ShawkyHanna/ovc/ovc5/hardware/carrier/interfaces.kicad_sch

## KiCad design ovc5/hardware/carrier/interfaces.kicad_sch (2021-05-21)

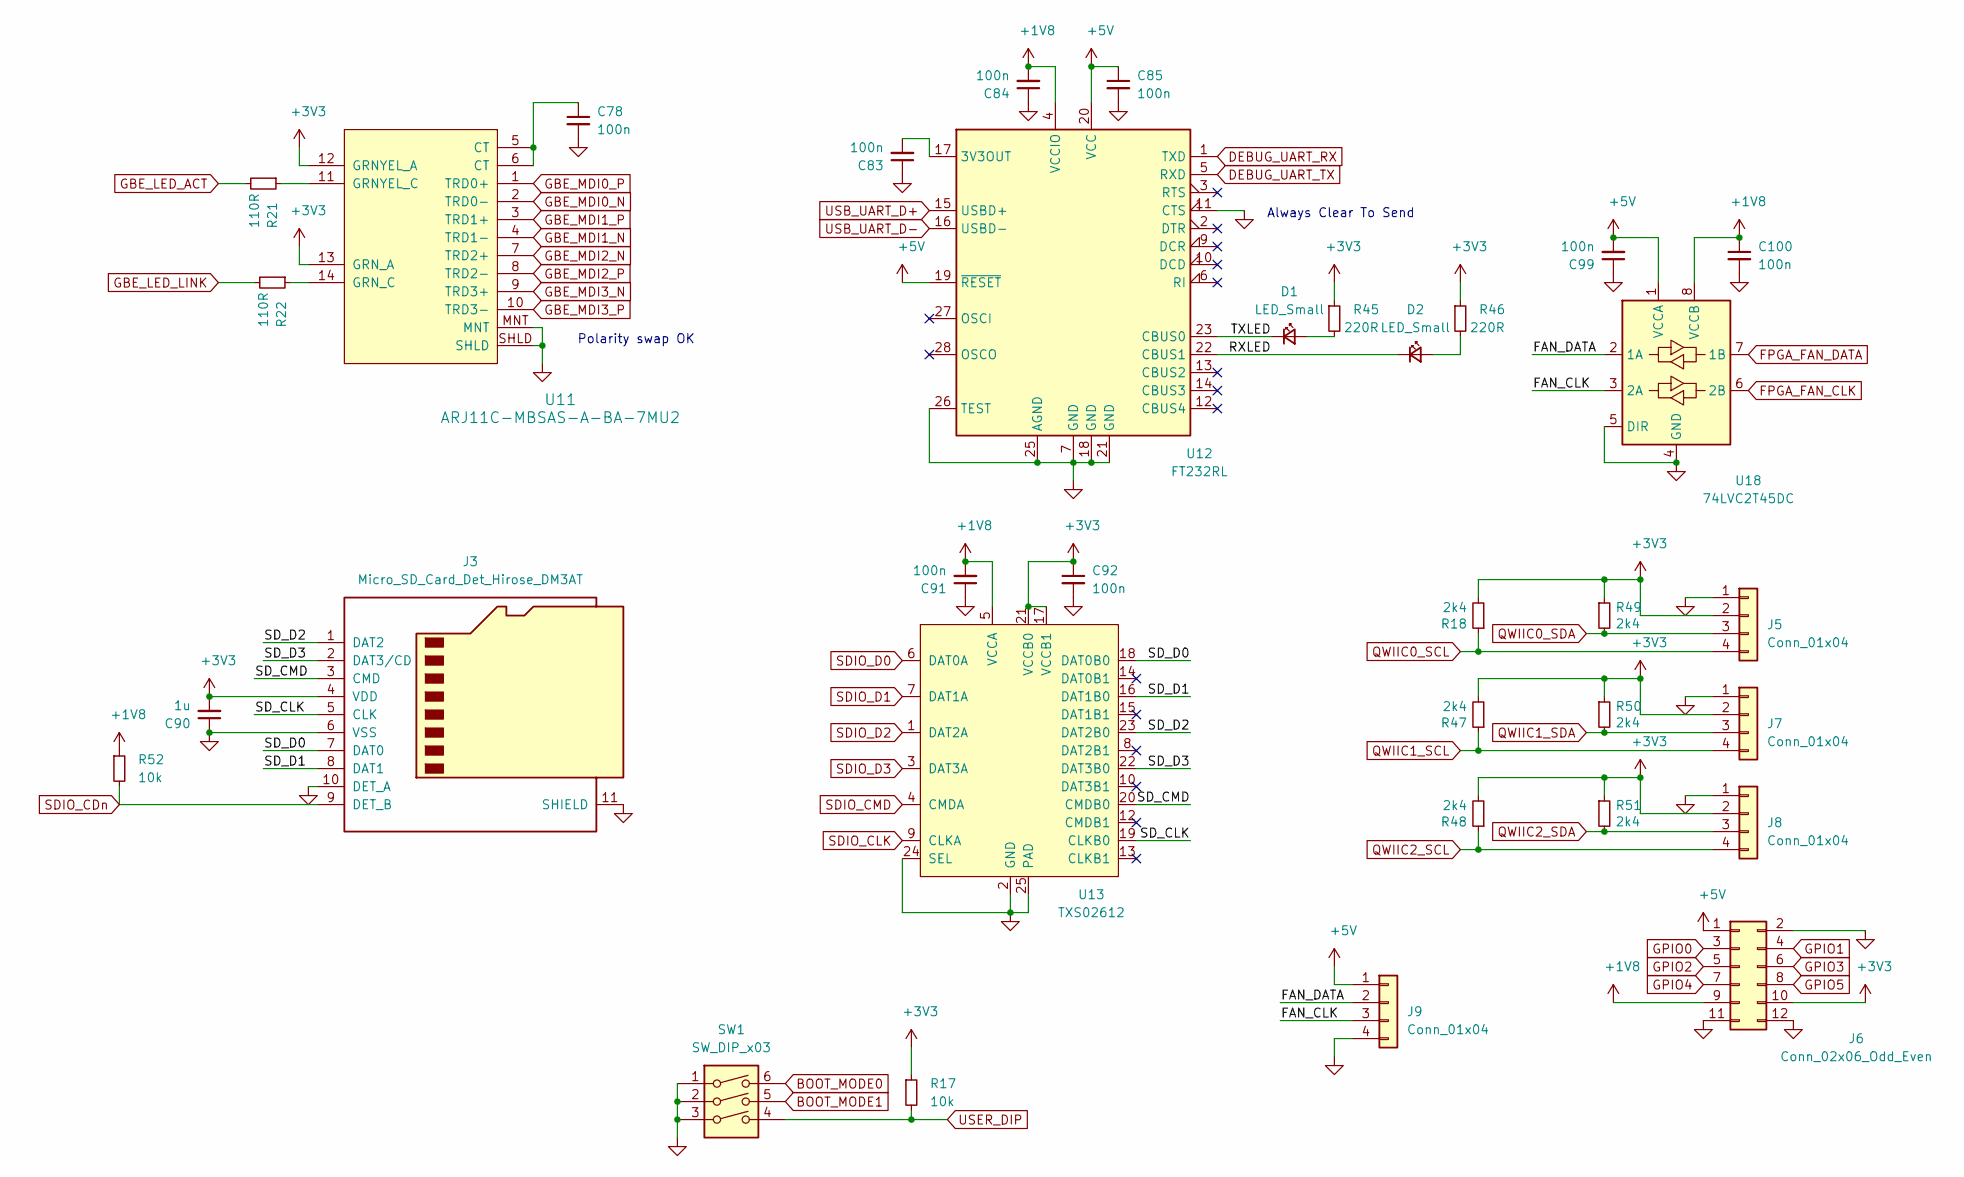
[picture p1: schematic interfaces.kicad_sch]

Parts:
C78, C83, C84, C85, C91, C92, C99, C100: 100n; C_0402_1005Metric; MPN CL05A104KA5NNNC
C90: 1u; C_0402_1005Metric; MPN CL05A105KP5NNNC
D1: LED_Small; LED_0402_1005Metric; MPN LT VH9G-Q2OO-25-1
D2: LED_Small; LED_0402_1005Metric; MPN LB QH9G-N1OO-35-1
J3: Micro_SD_Card_Det_Hirose_DM3AT; microSD_HC_Hirose_DM3AT-SF-PEJM5; MPN DM3AT-SF-PEJM5
J5, J7, J8: Conn_01x04; JST_SH_BM04B-SRSS-TB_1x04-1MP_P1.00mm_Vertical; MPN BM04B-SRSS-TB(LF)(SN)
J6: Conn_02x06_Odd_Even; PinHeader_2x06_P2.54mm_Vertical; MPN DNP
J9: Conn_01x04; Molex_SL_171971-0004_1x04_P2.54mm_Vertical; MPN 1719710004
R17, R52: 10k; R_0402_1005Metric; MPN AC0402FR-0710KL
R18, R47, R48, R49, R50, R51: 2k4; R_0402_1005Metric; MPN ERA-2AED242X
R21, R22: 110R; R_0603_1608Metric; MPN ERJ-2GEJ111X
R45, R46: 220R; R_0402_1005Metric; MPN RCS0402220RFKED
SW1: SW_DIP_x03; SW_DIP_SPSTx03_Slide_6.7x9.18mm_W6.73mm_P2.54mm_LowProfile_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; MPN CFS-0300TA
U11: ARJ11C-MBSAS-A-BA-7MU2; MPN ARJ11C-MBSAS-A-BA-7MU2
U12: FT232RL; SSOP-28_5.3x10.2mm_P0.65mm; MPN FT232RL-TUBE
U13: TXS02612; TI_RTW0024B; MPN TXS02612RTWR
U18: 74LVC2T45DC; VSSOP-8_2.3x2mm_P0.5mm; MPN 74LVC2T45DC,125

Connections:
+1V8: C84.2, C91.2, C100.1, J6.9, R52.1, U12.4 (VCCIO), U13.5 (VCCA), U18.8 (VCCB)
+3V3: C90.2, C92.1, J3.4 (VDD), J5.2, J6.10, J7.2, J8.2, R17.1, R18.2, R45.1, R46.1, R47.2, R48.2, R49.1, R50.1, R51.1, U11.12 (GRNYEL_A), U11.13 (GRN_A), U13.17 (VCCB1), U13.21 (VCCB0)
+5V: C85.1, C99.2, J6.1, J9.1, U12.19 (~RESET~), U12.20 (VCC), U18.1 (VCCA)
BOOT_MODE0: SW1.6
BOOT_MODE1: SW1.5
DEBUG_UART_RX: U12.1 (TXD)
DEBUG_UART_TX: U12.5 (RXD)
FAN_CLK: J9.3, U18.3 (2A)
FAN_DATA: J9.2, U18.2 (1A)
FPGA_FAN_CLK: U18.6 (2B)
FPGA_FAN_DATA: U18.7 (1B)
GBE_LED_ACT: R21.2
GBE_LED_LINK: R22.2
GBE_MDI0_N: U11.2 (TRD0-)
GBE_MDI0_P: U11.1 (TRD0+)
GBE_MDI1_N: U11.4 (TRD1-)
GBE_MDI1_P: U11.3 (TRD1+)
GBE_MDI2_N: U11.7 (TRD2+)
GBE_MDI2_P: U11.8 (TRD2-)
GBE_MDI3_N: U11.9 (TRD3+)
GBE_MDI3_P: U11.10 (TRD3-)
GND: C78.2, C83.1, C84.1, C85.2, C90.1, C91.1, C92.2, C99.1, C100.2, J3.6 (VSS), J3.10 (DET_A), J3.11 (SHIELD), J5.1, J6.2, J6.11, J6.12, J7.1, J8.1, J9.4, SW1.1, SW1.2, SW1.3, U11.MNT, U11.SHLD, U12.7 (GND), U12.11 (CTS), U12.18 (GND), U12.21 (GND), U12.25 (AGND), U12.26 (TEST), U13.2 (GND), U13.11 (GND), U13.24 (SEL), U13.25 (PAD), U18.4 (GND), U18.5 (DIR)
GPIO0: J6.3
GPIO1: J6.4
GPIO2: J6.5
GPIO3: J6.6
GPIO4: J6.7
GPIO5: J6.8
unnamed: C78.1, U11.5 (CT), U11.6 (CT)
unnamed: C83.2, U12.17 (3V3OUT)
unnamed: D1.2 (A), R45.2
unnamed: D2.2 (A), R46.2
unnamed: R21.1, U11.11 (GRNYEL_C)
unnamed: R22.1, U11.14 (GRN_C)
QWIIC0_SCL: J5.4, R18.1
QWIIC0_SDA: J5.3, R49.2
QWIIC1_SCL: J7.4, R47.1
QWIIC1_SDA: J7.3, R50.2
QWIIC2_SCL: J8.4, R48.1
QWIIC2_SDA: J8.3, R51.2
RXLED: D2.1 (K), U12.22 (CBUS1)
SDIO_CDn: J3.9 (DET_B), R52.2
SDIO_CLK: U13.9 (CLKA)
SDIO_CMD: U13.4 (CMDA)
SDIO_D0: U13.6 (DAT0A)
SDIO_D1: U13.7 (DAT1A)
SDIO_D2: U13.1 (DAT2A)
SDIO_D3: U13.3 (DAT3A)
SD_CLK: J3.5 (CLK), U13.19 (CLKB0)
SD_CMD: J3.3 (CMD), U13.20 (CMDB0)
SD_D0: J3.7 (DAT0), U13.18 (DAT0B0)
SD_D1: J3.8 (DAT1), U13.16 (DAT1B0)
SD_D2: J3.1 (DAT2), U13.23 (DAT2B0)
SD_D3: J3.2 (DAT3/CD), U13.22 (DAT3B0)
TXLED: D1.1 (K), U12.23 (CBUS0)
USB_UART_D+: U12.15 (USBD+)
USB_UART_D-: U12.16 (USBD-)
USER_DIP: R17.2, SW1.4

Notes on the sheet:
Polarity swap OK
Always Clear To Send
